swthemathwiz/hp-z4-front-fan-mount/hp-z4-front-fan-hardware.scad

//
// Copyright (c) Stewart H. Whitman, 2022-2024.
//
// File:    hp-z4-front-fan-hardware.scad
// Project: HP Z4 G4 Fan Mount
// License: CC BY-NC-SA 4.0 (Attribution-NonCommercial-ShareAlike)
// Desc:    Hardware Pack build
//

include <hp-z4-front-fan-mount.scad>
show_selection = "hardware";
