swthemathwiz/hp-z4-front-fan-mount/hp-z4-front-fan-mount-with-grill.scad

//
// Copyright (c) Stewart H. Whitman, 2024.
//
// File:    hp-z4-front-fan-mount-with-grill.scad
// Project: HP Z4 G4 Fan Mount
// License: CC BY-NC-SA 4.0 (Attribution-NonCommercial-ShareAlike)
// Desc:    Mount with grill build
//

include <hp-z4-front-fan-mount.scad>
grill_add = true;
baffle_screw_hole_oversize = false;
baffle_screw_hole_countersunk = true;
