swthemathwiz/hp-z4-front-fan-mount/(list of files, cad)

Other CAD files:
fan.scad
hash.scad
line.scad
polar.scad
rounded.scad
screw-hole.scad
smidge.scad
