swthemathwiz/hp-z4-front-fan-mount/(threads)

Thread 1 (2024-03-15):

Menory Fan

kentonbmax, 2024-03-15:
Could you do a diy memory cooling replacement? this 517 error is super frustrating. There is a way to bypass it but the cooler connector would be a great molex type fix.
https://www.reddit.com/r/HSpecWorkstations/comments/1aovkmw/hp_z6_g4_ram_upgrade_and_how_to_prevent_memory/

swthemathwiz, 2024-03-15:
If you're talking about the front memory fan on the Z6 G4? Seen here:
[Replace the Memory Fan - youtube](https://www.youtube.com/watch?v=rwtIkoE7kFc)
around time 0:32, you could probably do it, but I don't think that would get rid of the 517 error. I think the front memory fan comes standard.

Then there's the memory shroud that goes over the whole thing... and the single blower connects to the weird 4-pin header. As I understand it, that's what is being talked about in the reddit post. That's kind of a different beast entirely. You might be about to convert the front mount to essentially a double fan mount (side by side) - don't know about space - also might be a problem for second CPU.

But you'd still need the 4-pin adapter - to that black connector (looks like Molex Mini-Fit connector?). You'd want the full pinout - it could be reverse engineered from an existing shroud. I've seen the moddiy.com people stock those types of cables - fan adapters, etc., for various HP Zx and Zxxx parts, but I don't see anything similar in this case. You (or the reddit group) might approach them - 4-pin to standard or HP 4-pin fan adapter cable - and then a fan could be zip-tied at the front off the drive cage.

Based on the reddit fix, you could connect the fan to a drive power supply, and split off the tach. lead to the rear 4-pin connector, but the fan would run full blast.

swthemathwiz, 2024-05-29:
@kentonbmax I sent you an invite to a preliminary hp z6 g4 fan mount + cable repo (I am currently in parts limbo) if you would like to try it and/or give suggestions.
