swthemathwiz/hp-z4-front-fan-mount/(commit log)

2022-10-17 Initial commit.
    [arm.scad, fan.scad, fastener.scad, hash.scad, hp-z4-catch-bottom.scad, hp-z4-catch-top.scad, hp-z4-front-fan-hardware.scad, hp-z4-front-fan-mount.scad]
2022-10-18 Refactor with a little cleanup.
    [arm.scad, expo.scad]
2022-10-18 Add/fix variable desc. Decrease arm hole oversize. Correct position of machine's hole.
    [hp-z4-front-fan-mount.scad]
2022-10-19 Just use straight profile on tang.
    [arm.scad]
2022-10-19 Decrease separation to 24.5. Add layout build.
    [hp-z4-catch-top.scad]
2022-10-19 Add layout build.
    [hp-z4-catch-bottom.scad]
2022-10-19 Add machine view w/o axis. Add stopper to top arm. Alignment rework.
    [hp-z4-front-fan-mount.scad]
2022-10-20 Best alignment so far
    [hp-z4-catch-bottom.scad, hp-z4-front-fan-mount.scad]
2022-10-22 Make all layout boxes hollow. Run prong down to bottom of case.
    [hp-z4-catch-top.scad]
2022-10-22 Remove old experiments and rename some options. Add comments to layout.
    [hp-z4-catch-bottom.scad]
2022-10-22 Cut down on tab play. Adjust top/bottom alignment. Minor cosmetic changes. Adjust option names for bottom catch.
    [hp-z4-front-fan-mount.scad]
2022-10-23 Replace hexagon with regular_polygon to avoid warnings with old libraries.
    [fastener.scad]
2022-10-25 Update image sizes, add additional fan
2022-10-25 Comment change.
    [hp-z4-front-fan-hardware.scad]
2022-10-25 Remove old debug builds.
    [arm.scad]
2022-10-25 Ignore fan models.
2024-03-31 Fix comments missing attributes. Allow explicit thickness for washers, and nuts.
    [fastener.scad]
2024-03-31 Split off screw hole functionality.
    [hp-z4-front-fan-mount.scad, screw-hole.scad]
2024-03-31 Correct fastener file name. Split off screw-hole.
2024-03-31 Debug changes.
    [screw-hole.scad]
2024-03-31 Typo in comment
    [arm.scad]
2024-03-31 Typo in comments
    [fastener.scad]
2024-04-06 Fix variable name.
    [hp-z4-catch-bottom.scad]
2024-04-22 Correct comment on radius parameters
    [hp-z4-front-fan-mount.scad]
2024-04-22 Add area and volume convenience attributes
    [fan.scad]
2024-06-14 Sync with Z6 sources
    [fan.scad, rounded.scad]
2024-06-14 Bump copyright year
    [arm.scad, expo.scad, hash.scad, hp-z4-front-fan-hardware.scad, pair.scad, smidge.scad]
2024-06-14 Grill option addition
    [hp-z4-front-fan-mount-with-grill.scad, hp-z4-front-fan-mount.scad, line.scad, polar.scad]
2024-06-16 Split out HP fan comments like Z6 mount
